N11ckname/CalciferAi/Logger/logs/lucia_log_20251215_185044_analysis.png

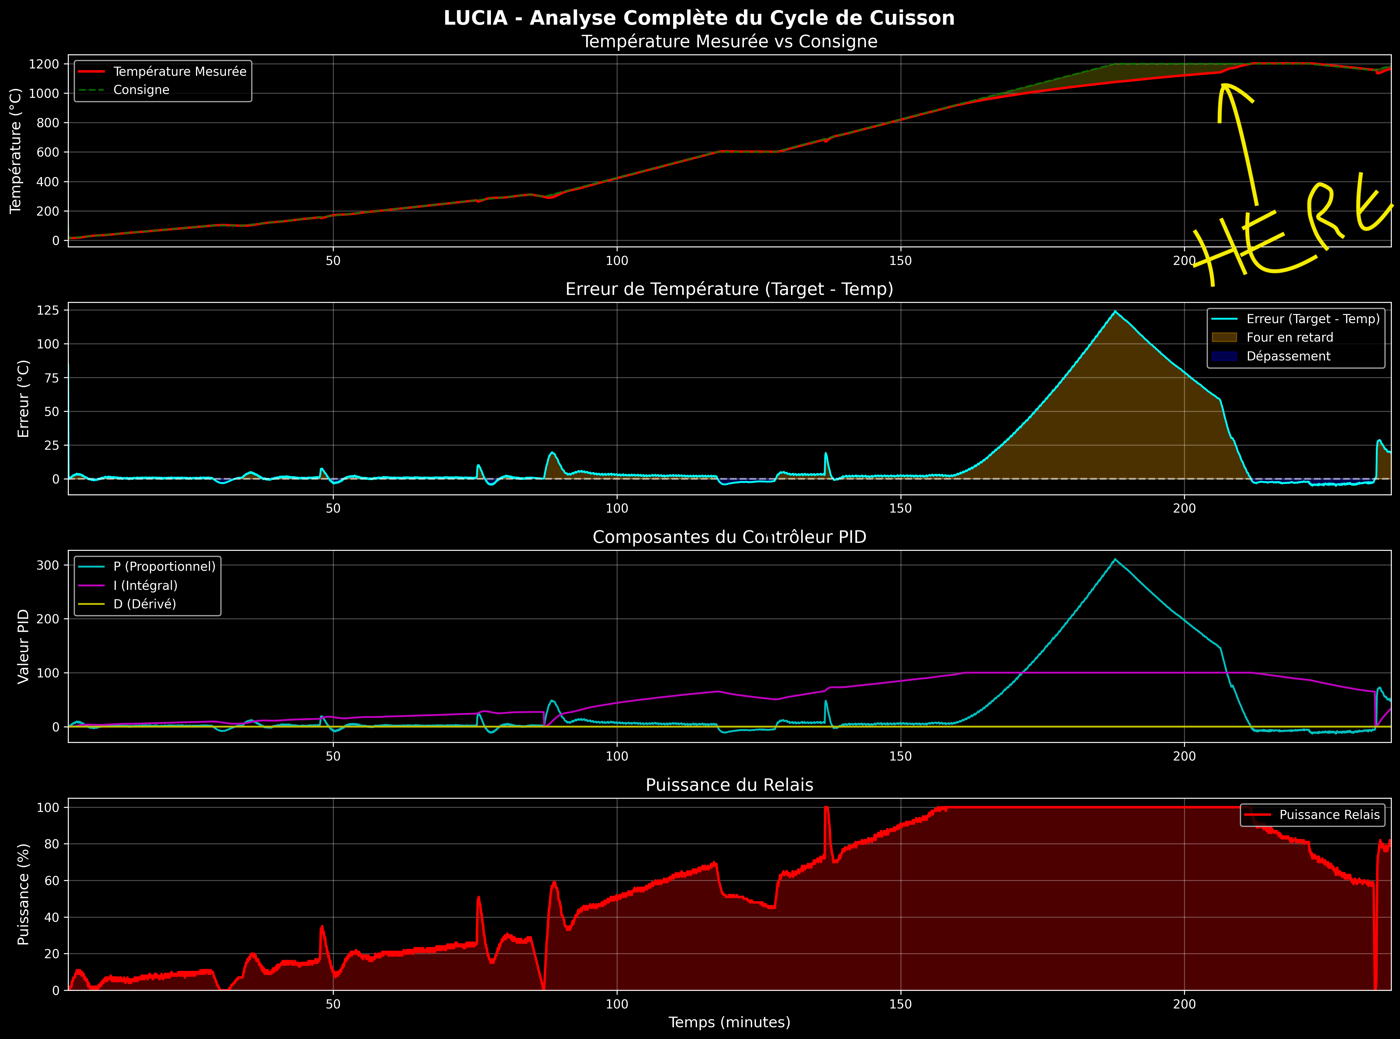
Logger/logs/lucia_log_20251215_185044_analysis.png
