N11ckname/CalciferAi/GUIDES/wiring diagram.pdf

# CALCIFER FURNACE REGULATOR

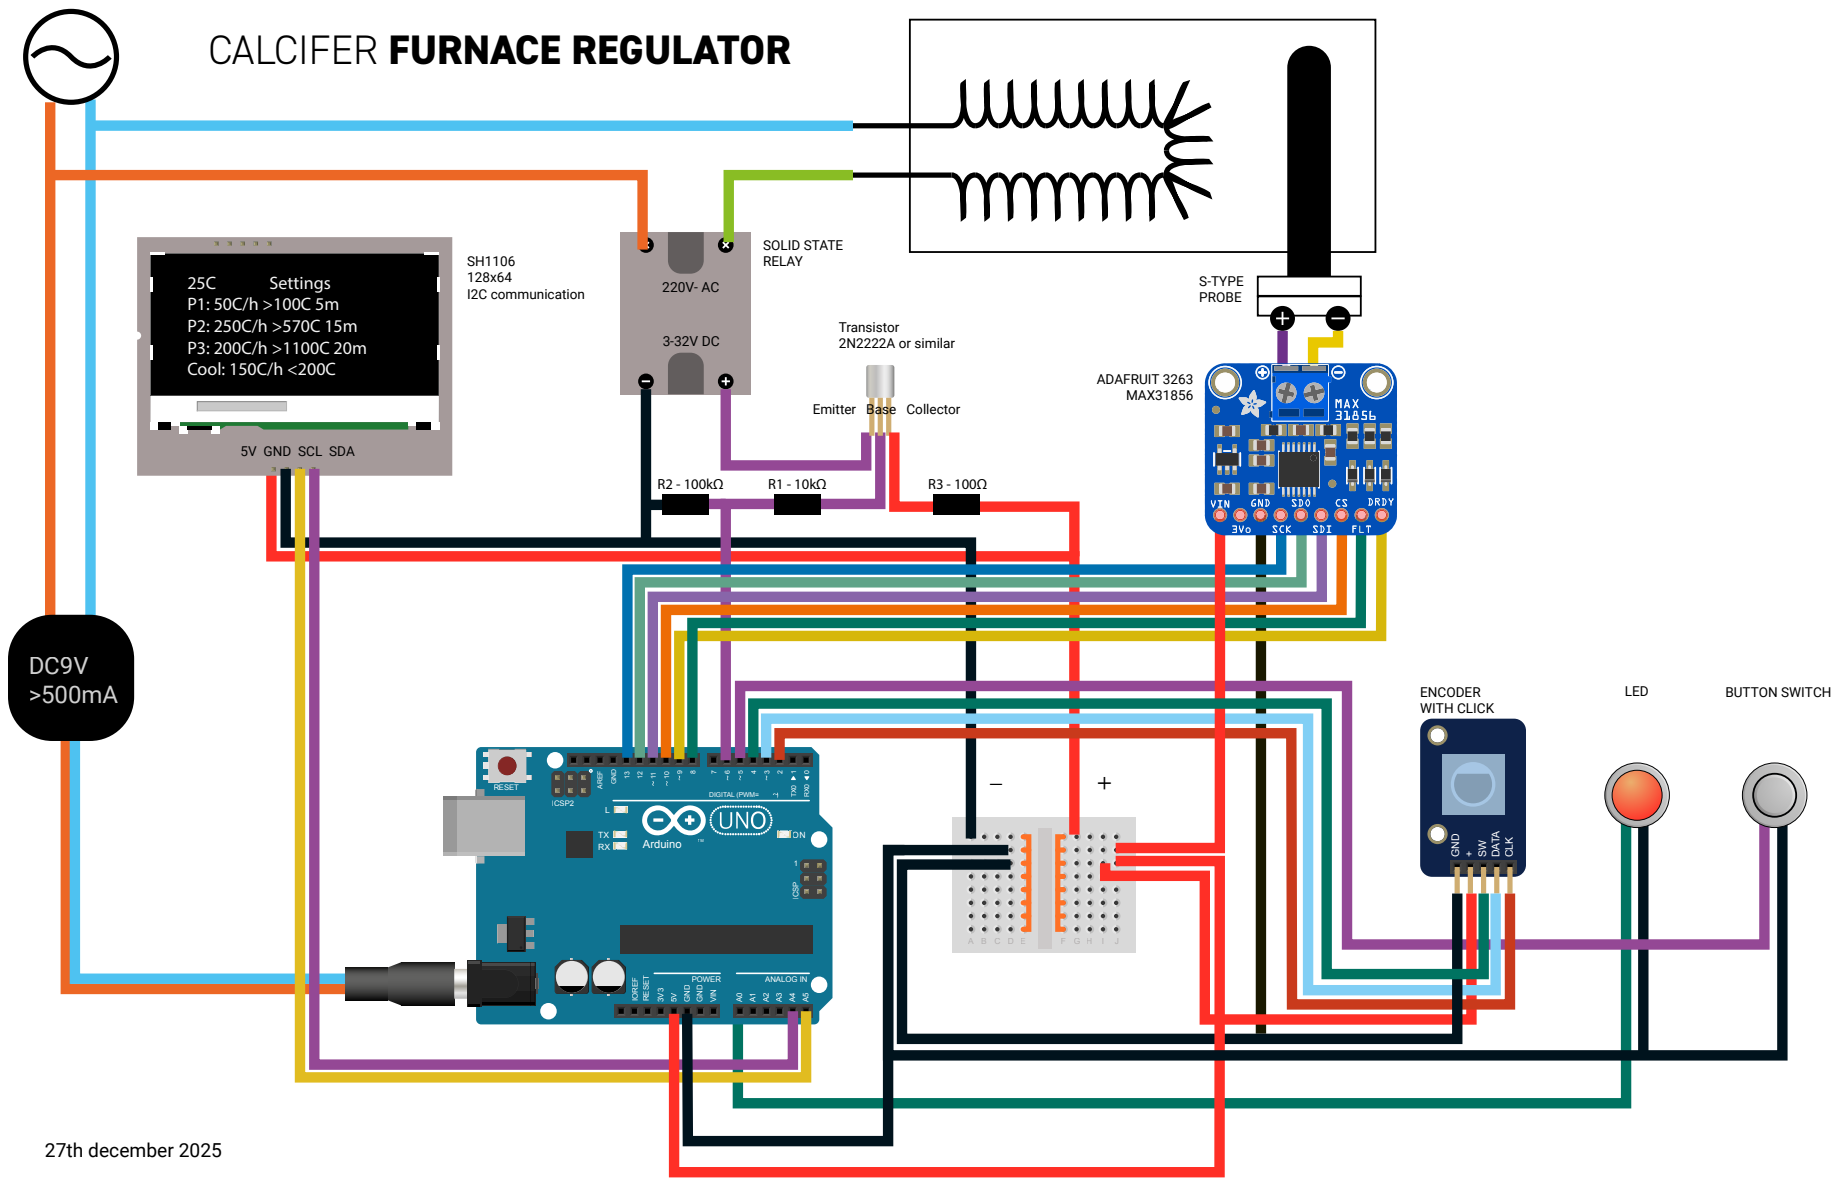
[picture p3: page 1]
ANALOG IN; AREF; GND; RESET; VIN; DIGITAL (PWM=; Arduino TM; IOREF; ICSP; ICSP2; POWER; DATA CLK; ENCODER WITH CLICK; LED; BUTTON SWITCH; ADAFRUIT 3263 MAX31856; SOLID STATE RELAY; Transistor 2N2222A or similar; S-TYPE PROBE; SH1106 128x64 I2C communication; 27th december 2025; Settings; P1: 50C/h >100C 5m P2: 250C/h >570C 15m P3: 200C/h >1100C 20m Cool: 150C/h <200C

Emitter Base Collector

5V GND SCL SDA
