N11ckname/CalciferAi/lucia/lucia.ino

/*
 * LUCIA - Contrôleur de four céramique
 * Système de thermostat intelligent pour four électrique
 */

#include <Wire.h>
#include <SPI.h>
#include <U8g2lib.h>
#include <Adafruit_MAX31856.h>
#include <Encoder.h>
#include <EEPROM.h>
#include "definitions.h"
#include "display.h"
#include "temperature.h"

// ===== PINS DEFINITION =====
#define PIN_ENCODER_CLK 2
#define PIN_ENCODER_DT 3
#define PIN_ENCODER_SW 4
#define PIN_PUSH_BUTTON 5
#define PIN_RELAY 6
#define PIN_MAX_CS 10
#define PIN_LED A1

// ===== GLOBAL OBJECTS =====
// Utilise mode 2-page au lieu de full buffer pour économiser ~768 octets de RAM
U8G2_SH1106_128X64_NONAME_2_HW_I2C u8g2(U8G2_R0, U8X8_PIN_NONE);
Adafruit_MAX31856 max31856 = Adafruit_MAX31856(PIN_MAX_CS);
Encoder encoder(PIN_ENCODER_CLK, PIN_ENCODER_DT);

// ===== PROGRAM STATE =====
ProgramState progState = PROG_OFF;
Phase currentPhase = PHASE_0;

// ===== FIRING PROGRAM PARAMETERS =====
FiringParams params = {100, 50, 5, 570, 250, 15, 1100, 200, 20, 150, 200};
FiringParams paramsBackup; // Sauvegarde pour détecter les changements

// ===== SETTINGS PARAMETERS =====
SettingsParams settings = {1000, 2.5, 0.03, 0.0, 10, 1200}; // pcycle (ms), kp, ki, kd (non utilisé), maxDelta (°C), maxTemp (°C)
SettingsParams settingsBackup; // Sauvegarde pour détecter les changements
int selectedSetting = 0;
const int NUM_SETTINGS = 6; // Heat Cycle, Kp, Ki, Max delta, Max Temp, Exit
int settingsScrollOffset = 0; // Scroll pour l'écran settings

// ===== UI PARAMETERS =====
EditMode editMode = NAV_MODE;
int selectedParam = 2; // Sélectionne step1Temp par défaut (Settings=0, step1Speed=1, step1Temp=2)
const int NUM_PARAMS = 12; // 12 paramètres (Settings + 11 paramètres de phases)
long encoderPosition = 0;

// ===== TIMING VARIABLES =====
unsigned long lastDisplayUpdate = 0;
unsigned long programStartTime = 0;
unsigned long phaseStartTime = 0;
unsigned long plateauStartTime = 0;
unsigned long tempFailStartTime = 0;
bool tempFailActive = false;
unsigned long lastTempRead = 0;
float cachedTemperature = NAN;
#ifdef ENABLE_GRAPH
unsigned long lastGraphUpdate = 0;
#endif
#ifdef ENABLE_LOGGING
unsigned long lastDataLog = 0;
#endif

// ===== EEPROM PROTECTION =====
unsigned long lastEEPROMWrite = 0;
bool eepromWriteAllowed = true;  // Permettre la première écriture au démarrage

// ===== BUTTON STATES =====
bool lastEncoderButton = HIGH;
bool lastPushButton = HIGH;
#ifdef ENABLE_GRAPH
bool showGraph = false;
#endif
bool criticalErrorActive = false;

// ===== TEMPERATURE CONTROL =====
float targetTemp = 0;
float phaseStartTemp = 0;  // Température de départ de la phase en cours
bool plateauReached = false;

// ===== EEPROM ADDRESSES =====
#define EEPROM_MAGIC 0x4C55  // "LU" magic number to detect first use
#define EEPROM_ADDR_MAGIC 0
#define EEPROM_ADDR_PARAMS 2

// ===== GRAPH DATA =====
#ifdef ENABLE_GRAPH
// Implémentation optimisée avec décimation adaptative (256 octets)
uint8_t graphTempRead[GRAPH_SIZE];
uint8_t graphTempTarget[GRAPH_SIZE];
uint16_t graphTimeStamps[GRAPH_SIZE];
uint8_t graphIndex = 0;
uint8_t graphCount = 0;
uint16_t samplingInterval = 5;
uint16_t nextSamplingTime = 5;
#endif

void setup() {
  #ifdef ENABLE_LOGGING
  Serial.begin(9600);
  while (!Serial && millis() < 1000);
  #endif
  
  // Initialize pins
  pinMode(PIN_ENCODER_SW, INPUT_PULLUP);
  pinMode(PIN_PUSH_BUTTON, INPUT_PULLUP);
  pinMode(PIN_RELAY, OUTPUT);
  pinMode(PIN_LED, OUTPUT);
  digitalWrite(PIN_RELAY, LOW);
  digitalWrite(PIN_LED, LOW);
  
  // Initialize display
  u8g2.begin();
  u8g2.setContrast(255);
  
  // Initialize SPI for MAX31856 (CRITICAL: must be before max31856.begin())
  pinMode(PIN_MAX_CS, OUTPUT);
  digitalWrite(PIN_MAX_CS, HIGH); // CS doit être HIGH quand non utilisé
  SPI.begin();
  
  // Attente non-bloquante pour stabilisation SPI (100ms)
  unsigned long spiInitTime = millis();
  while (millis() - spiInitTime < 100) {
    // Attente active pour stabilisation
  }
  
  // Initialize MAX31856
  if (!max31856.begin()) {
    criticalErrorActive = true;
    u8g2.clearBuffer();
    u8g2.setFont(u8g2_font_6x10_tf);
    u8g2.drawStr(0, 20, "MAX31856 Error!");
    u8g2.drawStr(0, 35, "Check wiring");
    u8g2.drawStr(0, 50, "Press to retry");
    u8g2.sendBuffer();
    // Ne pas bloquer, gérer dans loop()
  } else {
    max31856.setThermocoupleType(MAX31856_TCTYPE_S);
    max31856.setConversionMode(MAX31856_CONTINUOUS);
    
    // Attente non-bloquante pour la première conversion (500ms)
    unsigned long conversionStartTime = millis();
    while (millis() - conversionStartTime < 500) {
      // Attente active pour première conversion
    }
    
    // Test de lecture et initialisation du cache
    float testTemp = readTemperature();
    cachedTemperature = testTemp;
    lastTempRead = millis();
  }
  
  // Load parameters from EEPROM (initialise aussi les backups)
  loadFromEEPROM();
  
  // S'assurer que settings est synchronisé avec les valeurs PID réelles
  settings.kp = KP;
  settings.ki = KI;
  // settings.kd reste à 0.0 (non utilisé, mais gardé pour compatibilité EEPROM)
  // Mettre à jour le backup après synchronisation
  settingsBackup = settings;
  
  // Initialize temperature control
  initTemperatureControl();
  
  updateDisplay(0);
  #ifdef ENABLE_LOGGING
  sendStartupLog();
  #endif
}

void loop() {
  unsigned long currentMillis = millis();
  
  // Gestion de l'erreur critique MAX31856 (si détectée au setup)
  if (criticalErrorActive) {
    // Attendre un appui sur le bouton pour retry
    bool pushButton = digitalRead(PIN_PUSH_BUTTON);
    if (pushButton == LOW && lastPushButton == HIGH) {
      // Tentative de réinitialisation du MAX31856
      if (max31856.begin()) {
        max31856.setThermocoupleType(MAX31856_TCTYPE_S);
        max31856.setConversionMode(MAX31856_CONTINUOUS);
        criticalErrorActive = false;
        cachedTemperature = readTemperature();
        lastTempRead = currentMillis;
      }
    }
    lastPushButton = pushButton;
    return; // Ne rien faire d'autre tant que l'erreur n'est pas résolue
  }
  
  // Lecture température (intervalle défini pour optimiser les performances)
  float temp;
  if (currentMillis - lastTempRead >= TEMP_READ_INTERVAL) {
    temp = readTemperature();
    cachedTemperature = temp;
    lastTempRead = currentMillis;
  } else {
    temp = cachedTemperature; // Utiliser la dernière valeur lue
  }
  
  // Vérification des erreurs de lecture température
  if (isnan(temp) || temp < -100 || temp > 1500) {
    if (!tempFailActive) {
      tempFailActive = true;
      tempFailStartTime = currentMillis;
    } else if (currentMillis - tempFailStartTime > TEMP_FAIL_TIMEOUT) {
      // Erreur critique - arrêt du chauffage pour sécurité
      if (progState == PROG_ON) {
        progState = PROG_OFF;
        currentPhase = PHASE_0;
        setRelay(false);
      }
      tempFailActive = false; // Réinitialiser pour permettre une nouvelle tentative
    }
  } else {
    tempFailActive = false;
  }
  
  // Gestion des boutons
  handleButtons(currentMillis);
  
  // Gestion de l'encodeur (intervalle optimisé pour réduire la charge CPU)
  #ifdef ENABLE_GRAPH
  bool canUseEncoder = (progState == PROG_OFF || progState == SETTINGS) && !showGraph;
  #else
  bool canUseEncoder = (progState == PROG_OFF || progState == SETTINGS);
  #endif
  if (canUseEncoder) {
    static unsigned long lastEncoderCheck = 0;
    if (currentMillis - lastEncoderCheck >= ENCODER_CHECK_INTERVAL) {
      handleEncoder();
      lastEncoderCheck = currentMillis;
    }
  }
  
  // Mise à jour de l'état du programme
  if (progState == PROG_ON) {
    updateProgram(currentMillis, temp);
    #ifdef ENABLE_GRAPH
    updateGraphData(currentMillis, temp);
    #endif
    #ifdef ENABLE_LOGGING
    if (currentMillis - lastDataLog >= 5000) {
      sendDataLog(currentMillis, temp);
      lastDataLog = currentMillis;
    }
    #endif
  }
  
  // Mise à jour de l'affichage
  if (currentMillis - lastDisplayUpdate >= DISPLAY_UPDATE_INTERVAL) {
    lastDisplayUpdate = currentMillis;
    updateDisplay(currentMillis);
  }
  
  // Mise à jour du contrôle de température
  updateTemperatureControl(temp, targetTemp, progState == PROG_ON, currentMillis);
}

void handleButtons(unsigned long currentMillis) {
  // Gestion du bouton encodeur
  bool encoderButton = digitalRead(PIN_ENCODER_SW);
  
  if (encoderButton == LOW && lastEncoderButton == HIGH) {
    // Appui détecté - exécuter l'action immédiatement
    if (progState == PROG_ON) {
      #ifdef ENABLE_GRAPH
      showGraph = !showGraph;
      #endif
    } else if (progState == PROG_OFF) {
      if (selectedParam == 0 && editMode == NAV_MODE) {
        progState = SETTINGS;
        selectedSetting = 0;
        editMode = NAV_MODE;
      } else {
        toggleEditMode();
      }
    } else if (progState == SETTINGS) {
      if (selectedSetting == 5) {  // Exit est à l'index 5
        progState = PROG_OFF;
        selectedParam = 2; // Retour sur step1Temp par défaut
        editMode = NAV_MODE;
      } else {
        toggleSettingsEditMode();
      }
    }
  }
  
  lastEncoderButton = encoderButton;
  
  // Gestion du bouton push
  bool pushButton = digitalRead(PIN_PUSH_BUTTON);
  
  if (pushButton == LOW && lastPushButton == HIGH) {
    // Appui détecté - exécuter l'action immédiatement
    toggleProgState();
  }
  
  lastPushButton = pushButton;
}

void handleEncoder() {
  long newPosition = encoder.read() / 4;
  
  if (newPosition != encoderPosition) {
    // Inverser le sens du delta pour inverser la direction de défilement
    int delta = encoderPosition - newPosition;
    encoderPosition = newPosition;
    
    if (progState == SETTINGS) {
      // Gérer l'encodeur dans l'écran settings
      if (editMode == NAV_MODE) {
        // Navigate between settings (sans boucler)
        selectedSetting += delta;
        // Limiter aux bornes sans boucler
        if (selectedSetting < 0) selectedSetting = 0;
        if (selectedSetting >= NUM_SETTINGS) selectedSetting = NUM_SETTINGS - 1;
      } else {
        // Edit selected setting
        editSetting(delta);
      }
    } else if (progState == PROG_OFF) {
      // Gérer l'encodeur dans l'écran phase 0
      if (editMode == NAV_MODE) {
        // Navigate between parameters (sans boucler)
        selectedParam += delta;
        // Limiter aux bornes sans boucler
        if (selectedParam < 0) selectedParam = 0;
        if (selectedParam >= NUM_PARAMS) selectedParam = NUM_PARAMS - 1;
      } else {
        // Edit selected parameter (mais pas Settings qui est à l'index 0)
        if (selectedParam != 0) {
          editParameter(delta);
        }
      }
    }
  }
}

void toggleEditMode() {
  if (editMode == NAV_MODE) {
    editMode = EDIT_MODE;
    // Sauvegarder les valeurs actuelles pour détecter les changements
    paramsBackup = params;
  } else {
    editMode = NAV_MODE;
    // Sauvegarder seulement si les paramètres ont changé
    saveToEEPROMIfChanged();
  }
}

void toggleSettingsEditMode() {
  if (editMode == NAV_MODE) {
    editMode = EDIT_MODE;
    // Sauvegarder les valeurs actuelles pour détecter les changements
    settingsBackup = settings;
  } else {
    editMode = NAV_MODE;
    // Sauvegarder seulement si les settings ont changé
    saveSettingsToEEPROMIfChanged();
  }
}

void editSetting(int delta) {
  switch (selectedSetting) {
    case 0: // Heat Cycle (Pcycle)
      settings.pcycle += delta * 100; // Incrément de 100ms
      if (settings.pcycle < 100) settings.pcycle = 100;
      if (settings.pcycle > 10000) settings.pcycle = 10000;
      CYCLE_LENGTH = settings.pcycle; // Mettre à jour immédiatement
      break;
    case 1: // Kp - modifier directement la valeur réelle du PID
      KP += delta * 0.1; // Incrément de 0.1
      if (KP < 0.0) KP = 0.0;
      if (KP > 10.0) KP = 10.0;
      settings.kp = KP; // Synchroniser settings avec la valeur réelle
      break;
    case 2: // Ki - modifier directement la valeur réelle du PID
      KI += delta * 0.005; // Incrément de 0.005 (plus fin pour Ki faible)
      if (KI < 0.0) KI = 0.0;
      if (KI > 1.0) KI = 1.0; // Limiter à 1.0 (valeurs supérieures rarement utiles)
      settings.ki = KI; // Synchroniser settings avec la valeur réelle
      break;
    case 3: // Max delta
      settings.maxDelta += delta * 1; // Incrément de 1°C
      if (settings.maxDelta < 1) settings.maxDelta = 1;
      if (settings.maxDelta > 50) settings.maxDelta = 50;
      break;
    case 4: // Max Temp - température max du four
      settings.maxTemp += delta * 10; // Incrément de 10°C
      if (settings.maxTemp < 500) settings.maxTemp = 500;
      if (settings.maxTemp > 1500) settings.maxTemp = 1500;
      break;
    case 5: // Exit - ne rien faire, géré par le bouton
      break;
  }
}

void saveSettingsToEEPROM() {
  unsigned long currentMillis = millis();
  if (!eepromWriteAllowed && (currentMillis - lastEEPROMWrite < EEPROM_WRITE_MIN_INTERVAL)) return;
  EEPROM.put(EEPROM_ADDR_PARAMS + sizeof(FiringParams), settings);
  lastEEPROMWrite = currentMillis;
  eepromWriteAllowed = false;
}

void saveSettingsToEEPROMIfChanged() {
  if (memcmp(&settings, &settingsBackup, sizeof(SettingsParams)) != 0) {
    saveSettingsToEEPROM();
    settingsBackup = settings;
  }
}

void toggleProgState() {
  if (progState == PROG_OFF) {
    progState = PROG_ON;
    unsigned long now = millis();
    programStartTime = phaseStartTime = now;
    #ifdef ENABLE_GRAPH
    lastGraphUpdate = now;
    #endif
    plateauReached = false;
    
    float t = readTemperature();
    targetTemp = t;
    
    // Démarrage intelligent par détection de phase
    // phaseStartTemp = température réelle pour reprise à chaud, sinon température initiale
    if (!isnan(t) && t > 0) {
      if (t < params.step1Temp) {
        currentPhase = PHASE_1;
        phaseStartTemp = t;  // Température réelle au démarrage
      } else if (t < params.step2Temp) {
        currentPhase = PHASE_2;
        phaseStartTemp = t;  // Reprise à chaud : température réelle
      } else if (t < params.step3Temp) {
        currentPhase = PHASE_3;
        phaseStartTemp = t;  // Reprise à chaud : température réelle
      } else {
        currentPhase = PHASE_4_COOLDOWN;
        phaseStartTemp = t;  // Reprise à chaud : température réelle
      }
    } else {
      currentPhase = PHASE_1;
      targetTemp = 20.0;
      phaseStartTemp = 20.0;  // Valeur par défaut si lecture échoue
    }
    
    #ifdef ENABLE_GRAPH
    graphIndex = graphCount = 0;
    samplingInterval = nextSamplingTime = 5;
    #endif
    resetPID();
    
    #ifdef ENABLE_LOGGING
    sendProgramStartLog(t);
    #endif
  } else {
    #ifdef ENABLE_LOGGING
    sendProgramStopLog();
    #endif
    
    progState = PROG_OFF;
    currentPhase = PHASE_0;
    setRelay(false);
    #ifdef ENABLE_GRAPH
    showGraph = false;
    #endif
  }
}

void editParameter(int delta) {
  int* value;
  int minVal, maxVal, step;
  
  // Nouvel ordre: Settings en premier (0), puis les paramètres de phases (1-11)
  switch (selectedParam) {
    case 0: return; // Settings - ne peut pas être édité ici, géré par le bouton
    // Phase 1
    case 1: value = &params.step1Speed; minVal = 1; maxVal = 1000; step = 10; break;   // P1 gauche
    case 2: value = &params.step1Temp; minVal = 0; maxVal = settings.maxTemp; step = 5; break;     // P1 centre (limité par maxTemp)
    case 3: value = &params.step1Wait; minVal = 0; maxVal = 999; step = 1; break;      // P1 droite (1 min)
    // Phase 2
    case 4: value = &params.step2Speed; minVal = 1; maxVal = 1000; step = 10; break;   // P2 gauche
    case 5: value = &params.step2Temp; minVal = 0; maxVal = settings.maxTemp; step = 5; break;     // P2 centre (limité par maxTemp)
    case 6: value = &params.step2Wait; minVal = 0; maxVal = 999; step = 1; break;      // P2 droite (1 min)
    // Phase 3
    case 7: value = &params.step3Speed; minVal = 1; maxVal = 1000; step = 10; break;   // P3 gauche
    case 8: value = &params.step3Temp; minVal = 0; maxVal = settings.maxTemp; step = 5; break;     // P3 centre (limité par maxTemp)
    case 9: value = &params.step3Wait; minVal = 0; maxVal = 999; step = 1; break;      // P3 droite (1 min)
    // Cooldown
    case 10: value = &params.step4Speed; minVal = 1; maxVal = 1000; step = 10; break;  // Cool gauche
    case 11: value = &params.step4Target; minVal = 0; maxVal = 1000; step = 5; break;  // Cool droite (5°C)
    default: return;
  }
  
  *value += delta * step;
  if (*value < minVal) *value = minVal;
  if (*value > maxVal) *value = maxVal;
}

void updateProgram(unsigned long currentMillis, float currentTemp) {
  unsigned long phaseElapsed = currentMillis - phaseStartTime;
  
  switch (currentPhase) {
    case PHASE_1:
      // Utilise phaseStartTemp (température initiale) au lieu de currentTemp
      targetTemp = calculateTargetTemp(phaseStartTemp, params.step1Temp, params.step1Speed, phaseElapsed);
      if (checkPhaseComplete(currentTemp, params.step1Temp, plateauReached, plateauStartTime, params.step1Wait, currentMillis)) {
        currentPhase = PHASE_2;
        phaseStartTime = currentMillis;
        phaseStartTemp = params.step1Temp;  // Départ = cible du palier précédent
        plateauReached = false;
      }
      break;
      
    case PHASE_2:
      // Utilise phaseStartTemp (step1Temp) au lieu de currentTemp
      targetTemp = calculateTargetTemp(phaseStartTemp, params.step2Temp, params.step2Speed, phaseElapsed);
      if (checkPhaseComplete(currentTemp, params.step2Temp, plateauReached, plateauStartTime, params.step2Wait, currentMillis)) {
        currentPhase = PHASE_3;
        phaseStartTime = currentMillis;
        phaseStartTemp = params.step2Temp;  // Départ = cible du palier précédent
        plateauReached = false;
      }
      break;
      
    case PHASE_3:
      // Utilise phaseStartTemp (step2Temp) au lieu de currentTemp
      targetTemp = calculateTargetTemp(phaseStartTemp, params.step3Temp, params.step3Speed, phaseElapsed);
      if (checkPhaseComplete(currentTemp, params.step3Temp, plateauReached, plateauStartTime, params.step3Wait, currentMillis)) {
        currentPhase = PHASE_4_COOLDOWN;
        phaseStartTime = currentMillis;
        phaseStartTemp = params.step3Temp;  // Départ = cible du palier précédent
        plateauReached = false;
      }
      break;
      
    case PHASE_4_COOLDOWN:
      // Utilise phaseStartTemp (step3Temp) au lieu de currentTemp
      targetTemp = calculateCoolingTarget(phaseStartTemp, params.step4Target, params.step4Speed, phaseElapsed);
      if (currentTemp <= params.step4Target) {
        progState = PROG_OFF;
        currentPhase = PHASE_0;
        setRelay(false);
      }
      break;
  }
}

float calculateTargetTemp(float startTemp, int targetTemp, int speed, unsigned long elapsed) {
  // Calcul de la température cible basé sur la vitesse de montée (°C/h)
  // Conversion : elapsed (ms) -> heures -> température
  // Utilisation de float pour avoir une progression continue (pas de sauts de 1°C)
  float tempIncrease = (float)speed * (float)elapsed / 3600000.0;
  float calculatedTarget = startTemp + tempIncrease;
  return (calculatedTarget > targetTemp) ? (float)targetTemp : calculatedTarget;
}

float calculateCoolingTarget(float startTemp, int targetTemp, int speed, unsigned long elapsed) {
  // Calcul de la température cible basé sur la vitesse de descente (°C/h)
  // Conversion : elapsed (ms) -> heures -> température
  // Utilisation de float pour avoir une progression continue (pas de sauts de 1°C)
  float tempDecrease = (float)speed * (float)elapsed / 3600000.0;
  float calculatedTarget = startTemp - tempDecrease;
  return (calculatedTarget < targetTemp) ? (float)targetTemp : calculatedTarget;
}

bool checkPhaseComplete(float currentTemp, int phaseTemp, bool &reached, unsigned long &plateauStart, int waitMinutes, unsigned long currentMillis) {
  // Vérifier si la température est dans la tolérance (maxDelta en dessous) ET au-dessus de la cible
  if (!reached && currentTemp >= (phaseTemp - settings.maxDelta) && currentTemp >= phaseTemp) {
    reached = true;
    plateauStart = currentMillis;
  }
  if (reached && (currentMillis - plateauStart) >= (unsigned long)waitMinutes * 60000UL) {
    return true;
  }
  return false;
}

#ifdef ENABLE_GRAPH
uint8_t tempToUint8(float temp) {
  if (temp < 0) return 0;
  if (temp > 1280) return 255;
  return (uint8_t)(temp * 0.199);  // 255/1280 ≈ 0.199
}

void updateGraphData(unsigned long currentMillis, float temp) {
  uint16_t elapsed = (currentMillis - programStartTime) / 1000;
  if (elapsed < nextSamplingTime) return;
  
  graphTempRead[graphIndex] = tempToUint8(temp);
  graphTempTarget[graphIndex] = tempToUint8(targetTemp);
  graphTimeStamps[graphIndex] = elapsed;
  
  if (++graphIndex >= GRAPH_SIZE) graphIndex = 0;
  if (graphCount < GRAPH_SIZE) graphCount++;
  
  nextSamplingTime = elapsed + samplingInterval;
  
  static uint8_t cnt = 0;
  if (++cnt >= 20 && samplingInterval < 60) {
    samplingInterval += 5;
    if (samplingInterval > 60) samplingInterval = 60;
    cnt = 0;
  }
}
#endif

void updateDisplay(unsigned long currentMillis) {
  u8g2.firstPage();
  do {
    #ifdef ENABLE_GRAPH
    if (showGraph && progState == PROG_ON) {
      drawGraph();
    } else
    #endif
    if (tempFailActive && (currentMillis - tempFailStartTime > TEMP_FAIL_TIMEOUT)) {
      // Afficher l'erreur critique de température
      u8g2.setFont(u8g2_font_6x10_tf);
      u8g2.drawStr(0, 10, "ERROR!");
      u8g2.drawStr(0, 25, "Temp fail 2min");
      u8g2.drawStr(0, 40, "Heat stopped");
      u8g2.drawStr(0, 55, "Check sensor");
    } else {
      if (progState == SETTINGS) {
        drawSettingsScreen();
      } else if (progState == PROG_OFF) {
        drawProgOffScreen();
      } else {
        drawProgOnScreen(currentMillis);
      }
    }
  } while (u8g2.nextPage());
}

void saveToEEPROM() {
  unsigned long currentMillis = millis();
  if (!eepromWriteAllowed && (currentMillis - lastEEPROMWrite < EEPROM_WRITE_MIN_INTERVAL)) return;
  EEPROM.put(EEPROM_ADDR_MAGIC, EEPROM_MAGIC);
  EEPROM.put(EEPROM_ADDR_PARAMS, params);
  lastEEPROMWrite = currentMillis;
  eepromWriteAllowed = false;
}

void saveToEEPROMIfChanged() {
  if (memcmp(&params, &paramsBackup, sizeof(FiringParams)) != 0) {
    saveToEEPROM();
    paramsBackup = params;
  }
}

void saveAllToEEPROM() {
  // Sauvegarder magic + params + settings en une fois
  EEPROM.put(EEPROM_ADDR_MAGIC, EEPROM_MAGIC);
  EEPROM.put(EEPROM_ADDR_PARAMS, params);
  EEPROM.put(EEPROM_ADDR_PARAMS + sizeof(FiringParams), settings);
  lastEEPROMWrite = millis();
  eepromWriteAllowed = false;
}

void loadFromEEPROM() {
  uint16_t magic;
  EEPROM.get(EEPROM_ADDR_MAGIC, magic);
  
  if (magic == EEPROM_MAGIC) {
    EEPROM.get(EEPROM_ADDR_PARAMS, params);
    EEPROM.get(EEPROM_ADDR_PARAMS + sizeof(FiringParams), settings);
    
    // Valider settings
    settings.kp = constrain(settings.kp, 0.0, 10.0);
    settings.ki = constrain(settings.ki, 0.0, 10.0);
    settings.kd = 0.0;  // Forcer à 0 (non utilisé)
    settings.pcycle = constrain(settings.pcycle, 100, 10000);
    settings.maxDelta = constrain(settings.maxDelta, 1, 50);
    settings.maxTemp = constrain(settings.maxTemp, 500, 1500);
    if (settings.maxTemp == 0) settings.maxTemp = 1200;  // Valeur par défaut si EEPROM vide
    
    CYCLE_LENGTH = settings.pcycle;
    KP = settings.kp;
    KI = settings.ki;
    // KD supprimé (non utilisé)
  } else {
    saveAllToEEPROM();
  }
  paramsBackup = params;
  settingsBackup = settings;
}

// Fonction pour obtenir la température mise en cache (lue toutes les 500ms dans loop())
float getCurrentTemperature() {
  return cachedTemperature;
}

#ifdef ENABLE_LOGGING
// Logging formaté pour meilleure lisibilité
void sendStartupLog() {
  Serial.println(F("=== LUCIA START ==="));
  Serial.print(F("PID: Kp="));
  Serial.print(KP);
  Serial.print(F(" Ki="));
  Serial.println(KI);
  Serial.println(F("Time(ms), Temp(C), Target(C), P, I, Power(%), Error(C)"));
  Serial.println(F("---"));
}

void sendDataLog(unsigned long t, float temp) {
  Serial.print(t);
  Serial.print(F(", "));
  Serial.print(temp, 1);
  Serial.print(F(", "));
  Serial.print(targetTemp, 1);
  Serial.print(F(", "));
  Serial.print(getPIDProportional(), 1);
  Serial.print(F(", "));
  Serial.print(getPIDIntegral(), 1);
  Serial.print(F(", "));
  Serial.print(getPowerHold());
  Serial.print(F(", "));
  Serial.println(getPIDError(), 1);
}

void sendProgramStartLog(float temp) {
  Serial.println();
  Serial.println(F(">>> PROGRAMME DEMARRE <<<"));
  Serial.print(F("Temperature initiale: "));
  Serial.print(temp, 1);
  Serial.println(F("C"));
  Serial.print(F("Phase detectee: "));
  Serial.println(currentPhase);
  Serial.println();
  
  // Paramètres PID
  Serial.print(F("PID: Kp="));
  Serial.print(KP, 2);
  Serial.print(F(" Ki="));
  Serial.print(KI, 2);
  Serial.print(F(" maxDelta="));
  Serial.print(settings.maxDelta);
  Serial.println(F("C"));
  Serial.println();
  
  // Paramètres des phases
  Serial.println(F("=== PROGRAMME DE CUISSON ==="));
  Serial.print(F("Phase 1: "));
  Serial.print(params.step1Speed);
  Serial.print(F("C/h -> "));
  Serial.print(params.step1Temp);
  Serial.print(F("C, palier "));
  Serial.print(params.step1Wait);
  Serial.println(F(" min"));
  
  Serial.print(F("Phase 2: "));
  Serial.print(params.step2Speed);
  Serial.print(F("C/h -> "));
  Serial.print(params.step2Temp);
  Serial.print(F("C, palier "));
  Serial.print(params.step2Wait);
  Serial.println(F(" min"));
  
  Serial.print(F("Phase 3: "));
  Serial.print(params.step3Speed);
  Serial.print(F("C/h -> "));
  Serial.print(params.step3Temp);
  Serial.print(F("C, palier "));
  Serial.print(params.step3Wait);
  Serial.println(F(" min"));
  
  Serial.print(F("Refroidissement: "));
  Serial.print(params.step4Speed);
  Serial.print(F("C/h -> "));
  Serial.print(params.step4Target);
  Serial.println(F("C"));
  Serial.println(F("============================"));
  Serial.println(F("---"));
}

void sendProgramStopLog() {
  Serial.println();
  Serial.println(F("<<< PROGRAMME ARRETE >>>"));
  Serial.print(F("Temperature finale: "));
  Serial.print(cachedTemperature, 1);
  Serial.println(F("C"));
  Serial.println(F("---"));
}
#endif
