N11ckname/CalciferAi/lucia/definitions.h

/*
 * definitions.h - Définitions communes pour tous les fichiers
 */

#ifndef DEFINITIONS_H
#define DEFINITIONS_H

// ===== PROGRAM STATES =====
enum ProgramState { PROG_OFF, PROG_ON, SETTINGS };
enum Phase { PHASE_0, PHASE_1, PHASE_2, PHASE_3, PHASE_4_COOLDOWN };
enum EditMode { NAV_MODE, EDIT_MODE };

// ===== TIMING CONSTANTS =====
#define TEMP_READ_INTERVAL 500
#define DISPLAY_UPDATE_INTERVAL 100
#define ENCODER_CHECK_INTERVAL 20
#define TEMP_FAIL_TIMEOUT 120000
#define EEPROM_WRITE_MIN_INTERVAL 10000

// ===== FONCTIONNALITÉS OPTIONNELLES =====
// Décommentez pour activer (voir ACTIVATION_FONCTIONNALITES.md pour détails)
#define ENABLE_LOGGING  // Logging Serial (~250 octets) - Monitoring/Debug
//#define ENABLE_GRAPH    // Graphe température (~800 octets) - Visualisation

// ===== GRAPH CONSTANTS =====
#define GRAPH_SIZE 64  // Nombre de points (64 points = ~2-3h couverture)

// ===== FIRING PARAMETERS STRUCTURE =====
struct FiringParams {
  int step1Temp;
  int step1Speed;
  int step1Wait;
  int step2Temp;
  int step2Speed;
  int step2Wait;
  int step3Temp;
  int step3Speed;
  int step3Wait;
  int step4Speed;
  int step4Target;
};

// ===== SETTINGS PARAMETERS STRUCTURE =====
struct SettingsParams {
  int pcycle;      // Cycle PWM en millisecondes
  float kp;        // Gain proportionnel PID
  float ki;        // Gain intégral PID
  float kd;        // Gain dérivé PID
  int maxDelta;    // Erreur max (°C) pour passer à phase suivante
  int maxTemp;     // Température max du four (°C)
};

#endif
