N11ckname/CalciferAi/(commit log)

2025-12-01 Generation Version 01 avec IA. Versions de test matériel en plus.
2025-12-07 Ajout de la gestion du PWM logiciel pour un contrôle précis de la température, avec mise à jour du calcul PID toutes les secondes. Amélioration de la clarté des commentaires en français.
2025-12-08 stable time for pid
2025-12-15 Loggeur, corrections du calcul, choix log ou graph
    [lucia_log_20251215_013242.csv]
2025-12-15 PID algo tuning
    [lucia_log_20251215_013242.csv, lucia_log_20251215_014432.csv, lucia_log_20251215_015247.csv]
2025-12-15 Log graph tuning
    [lucia_log_20251215_020337.csv, lucia_log_20251215_020616.csv]
2025-12-15 1st log de tout un programme jusqu'a 1200C et améliorations
    [lucia_log_20251215_013242.csv, lucia_log_20251215_014432.csv, lucia_log_20251215_015247.csv, lucia_log_20251215_020337.csv, lucia_log_20251215_185044.csv]
2025-12-15 PID optimisés + qq améliorations
2025-12-15 Corrections avec Opus, Mode Auto tout pourri
    [lucia_log_20251215_235518.csv, lucia_log_20251215_235722.csv]
2025-12-17 num de version
2025-12-19 Amélioration de la notice utilisateur et du prompt : ajout de fonctionnalités optionnelles, mise à jour des paramètres PID, et clarification des instructions de navigation.
2025-12-22 Organisation des dossiers et notices
    [lucia_log_20251215_020616.csv, lucia_log_20251215_185044.csv, lucia_log_20251215_235518.csv, lucia_log_20251215_235722.csv, lucia_log_20251222_215408.csv]
